rondorkerin/AVR-Robot-Chess/src/tests/integrationtest.h

/*
 * integrationtest.h
 *
 * Created: 9/14/2012 11:58:43 AM
 *  Author: nul4x3r0000
 */ 


#ifndef INTEGRATIONTEST_H_
#define INTEGRATIONTEST_H_

void integration_test_init();
void xyz_stepper_test();
void button_press_test(int side);
void get_move_test(int side);
void game_play_no_motors_test(int side);
void move_piece_test();
void game_play_test(int side);

#endif /* INTEGRATIONTEST_H_ */
