rondorkerin/AVR-Robot-Chess/(commit log)

2012-08-12 Working on windows chess engine interface - beginning refactorization process
    [TcfTransactionLog.csv]
2012-08-22 Added arduino sketch for serial debugging
2012-09-03 added LCD display arduino sketch and motor driver changes
2012-09-15 Added Integration tests for Human Machine Interface and implemented prototype HMI
2012-11-26 Finished project #1
    [TcfTransactionLog.csv]
